myriadrf/LimeSDR-X3/hardware/1v0/Project Outputs for LimeSDR-X3_1v0/DRC/LimeSDR-X3_1v0.html

Altium

# Design Rule Verification Report

Date: | | 2022-12-19
Time: | | 12:21:42
Elapsed Time: | | 00:03:39
Filename: | | E:\Saniok\Lime Micro\Lime PCBs\LimeSDR-X3_1v0\Altium designer design files\PCB\LimeSDR-X3_1v0.PcbDoc

Warnings: | | 0
Rule Violations: | | 0

## Summary

Warnings | Count
Total | 0

Rule Violations | Count
Clearance Constraint (Gap=0.1mm) (All),(All) | 0
Short-Circuit Constraint (Allowed=No) (All),(All) | 0
Short-Circuit Constraint (Allowed=Yes) ((ObjectKind = 'Pad') And (Component = 'IC40') And (Name = 'IC40-PAD') And (AsMM(PadXSize_AllLayers) = 1.4) And (AsMM(PadYSize_AllLayers) = 1.6)),(isvia) | 0
Un-Routed Net Constraint ( (All) ) | 0
Modified Polygon (Allow modified: No), (Allow shelved: No) | 0
Width Constraint (Min=0.1mm) (Max=7mm) (Preferred=0.2mm) (All) | 0
Width Constraint (Min=0.1mm) (Max=5mm) (Preferred=0.2mm) (All) | 0
Routing Layers(All) | 0
Routing Via (MinHoleWidth=0.2mm) (MaxHoleWidth=4.5mm) (PreferredHoleWidth=0.2mm) (MinWidth=0.31mm) (MaxWidth=5mm) (PreferedWidth=0.4mm) (All) | 0
Differential Pairs Uncoupled Length using the Gap Constraints (Min=0.1mm) (Max=0.3mm) (Prefered=0.14mm) and Width Constraints (Min=0.1mm) (Max=0.3mm) (Prefered=0.2mm) (InNetClass('LMS1_RX_RF') or InNetClass('LMS2_RX_RF') or InNetClass('LMS3_RX_RF')) | 0
Differential Pairs Uncoupled Length using the Gap Constraints (Min=0.1mm) (Max=0.3mm) (Prefered=0.1mm) and Width Constraints (Min=0.1mm) (Max=0.5mm) (Prefered=0.2mm) (All) | 0
Differential Pairs Uncoupled Length using the Gap Constraints (Min=0.1mm) (Max=0.3mm) (Prefered=0.14mm) and Width Constraints (Min=0.2mm) (Max=0.2mm) (Prefered=0.2mm) (InNetClass('RAPI_HDMI')) | 0
Differential Pairs Uncoupled Length using the Gap Constraints (Min=0.1mm) (Max=0.3mm) (Prefered=0.14mm) and Width Constraints (Min=0.1mm) (Max=0.3mm) (Prefered=0.2mm) (InNetClass('LMS1_TX_RF') or InNetClass('LMS2_TX_RF') or InNetClass('LMS3_TX_RF')) | 0
Power Plane Connect Rule(Relief Connect )(Expansion=0.508mm) (Conductor Width=0.254mm) (Air Gap=0.254mm) (Entries=4) (All) | 0
Hole Size Constraint (Min=0.2mm) (Max=10mm) (All) | 0
Pads and Vias to follow the Drill pairs settings | 0
Hole To Hole Clearance (Gap=0.15mm) (All),(All) | 0
Minimum Solder Mask Sliver (Gap=0.099mm) (All),(All) | 0
Net Antennae (Tolerance=0mm) (All) | 0
Matched Lengths(Tolerance=1.6mm) (InNetClass('LMS3_BB_ADC2_DATA')) | 0
Matched Lengths(Tolerance=1.6mm) (InNetClass('LMS2_BB_ADC1_DATA')) | 0
Matched Lengths(Tolerance=1.6mm) (InNetClass('LMS2_BB_ADC2_DATA')) | 0
Matched Lengths(Tolerance=1.6mm) (InNetClass('LMS3_BB_ADC1_DATA')) | 0
Matched Lengths(Tolerance=1mm) (InNetClass('LMS2_PORT2')) | 0
Matched Lengths(Tolerance=1mm) (InNetClass('LMS1_PORT1')) | 0
Matched Lengths(Tolerance=1mm) (InNetClass('LMS2_PORT1')) | 0
Matched Lengths(Tolerance=1.6mm) (InNetClass('LMS2_BB_DAC1_DATA')) | 0
Matched Lengths(Tolerance=1mm) (InNetClass('LMS1_PORT2')) | 0
Matched Lengths(Tolerance=1.6mm) (InNetClass('LMS2_BB_DAC2_DATA')) | 0
Matched Lengths(Tolerance=1.6mm) (InNetClass('LMS3_BB')) | 0
Component Clearance Constraint ( Horizontal Gap = -1mm, Vertical Gap = Infinite ) (HasFootprint('SW_4WAY_SMD_1P27_v2')),(All) | 0
Component Clearance Constraint ( Horizontal Gap = -1mm, Vertical Gap = Infinite ) (HasFootprint('RFI_SHIELD_BMI-S-230-F-R')),(All) | 0
Component Clearance Constraint ( Horizontal Gap = -1mm, Vertical Gap = Infinite ) (InComponent('IC40')),(InComponent('IC41')) | 0
Component Clearance Constraint ( Horizontal Gap = -1mm, Vertical Gap = Infinite ) (InComponent('IC36')),(InComponent('IC37')) | 0
Component Clearance Constraint ( Horizontal Gap = -1mm, Vertical Gap = Infinite ) (InComponent('MECH20')),(All) | 0
Component Clearance Constraint ( Horizontal Gap = -1mm, Vertical Gap = Infinite ) (InComponent('R454') or InComponent('R459')),(InComponent('R454') or InComponent('R459')) | 0
Component Clearance Constraint ( Horizontal Gap = -5mm, Vertical Gap = 0.254mm ) (HasFootprint('SFP_Chassis_22273021')),(HasFootprint('SFP_CON_x1_1367073-1')) | 0
Component Clearance Constraint ( Horizontal Gap = 0.01mm, Vertical Gap = 0.254mm ) (All),(All) | 0
Component Clearance Constraint ( Horizontal Gap = -1mm, Vertical Gap = Infinite ) (InComponent('R425') or InComponent('R430') or InComponent('R434')),(InComponent('R425') or InComponent('R430') or InComponent('R434')) | 0
Component Clearance Constraint ( Horizontal Gap = -1mm, Vertical Gap = Infinite ) ((ObjectKind = '3D Body') And (Layer = 'Mechanical13') And (ModelType = 'Extruded') And ((Identifier = 'RFshield') or (Identifier = 'RFshieldTop'))),((ObjectKind = '3D Body') And (Layer = 'Mechanical13') And (ModelType = 'Extruded') And ((Identifier = 'RFshield') or (Identifier = 'RFshieldTop'))) | 0
Height Constraint (Min=0mm) (Max=25.4mm) (Prefered=12.7mm) (All) | 0
Total | 0
