myriadrf/LimeSDR-X3/docs/documentation/images/PCIe_5GRadio_v3.0_3D.png

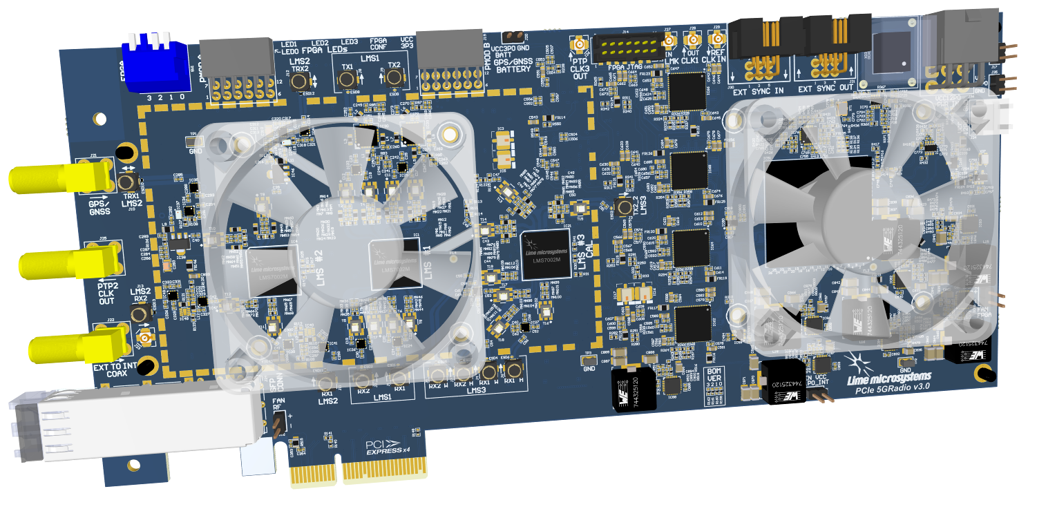
docs/documentation/images/PCIe_5GRadio_v3.0_3D.png
