myriadrf/LimeSDR-X3/hardware/1v1/LimeSDR-X3_1v1_DB_DFMr1/BOM/LimeSDR-X3_1v1_BOMr1.xls

Item # | Comment | Quantity | Designator | Footprint | Manufacturer | Manufacturer Part Number 1 | Supplier 1 | Supplier Part Number 1 | Part Description | Assembly Info | Number of NF parts in row | Number of fitted parts in row | Check
1 | LR44R Battery | 1 | BATT1 |  | Murata | LR44R | DigiKey | 490-LR44R-ND | Coin, 11.6mm Alkaline Manganese Dioxide 1.5 V Battery Non-Rechargeable (Primary) | NF(BATT1) | 1 | 0
2 | LR44R Battery Holder | 1 | BATTH1 | LR44R_BATTERY_HOLDER | Keystone Electronics | 2996 | Digi-Key | 36-2996-ND | Battery Retainer Coin, 11.6mm 1 Cell SMD (SMT) Tab | NF(BATTH1) | 1 | 0
3 | 10pF, 25V | 6 | C1, C3, C5, C783, C790, C793 | CAP0402 | AVX | 04023A100JAT2A | Farnell | 2332478RL | 10pF ±5% 25V C0G, NP0 Ceramic Capacitor -55°C ~ 125°C Surface Mount, MLCC 0402 (1005 Metric) 0.039" L x 0.020" W (1.00mm x 0.50mm) |  |  | 6 | OK
4 | 1uF, 10V | 54 | C2, C4, C6, C259, C260, C261, C275, C282, C283, C284, C298, C317, C322, C344, C349, C500, C512, C524, C525, C535, C538, C542, C545, C553, C556, C559, C562, C567, C574, C701, C702, C716, C720, C722, C727, C730, C748, C758, C771, C772, C784, C788, C808, C819, C820, C834, C859, C860, C861, C886, C887, C888, C905, C939 | CAP0402 | TDK | C1005X5R1E105K050BC | Digi-Key | 445-9066-1-ND | 1µF ±10% 10V X5R Ceramic Capacitor -55°C ~ 85°C Surface Mount, MLCC 0402 (1005 Metric) 0.039" L x 0.020" W (1.00mm x 0.50mm) | NF(C748 C758 C771 C772) | 4 | 50 | OK
5 | 100nF, 16V | 313 | C7, C9, C11, C14, C17, C20, C21, C24, C25, C26, C43, C46, C47, C50, C55, C57, C60, C62, C65, C68, C69, C263, C276, C280, C286, C299, C303, C307, C312, C318, C333, C337, C345, C359, C360, C361, C362, C363, C364, C365, C366, C367, C368, C369, C370, C371, C379, C380, C383, C384, C385, C386, C387, C388, C391, C392, C393, C394, C395, C396, C399, C400, C401, C402, C403, C404, C407, C408, C409, C410, C411, C412, C415, C416, C417, C418, C419, C420, C423, C424, C425, C426, C427, C428, C431, C432, C433, C434, C435, C436, C439, C440, C441, C442, C443, C444, C449, C450, C451, C452, C453, C454, C455, C456, C457, C458, C459, C460, C461, C464, C465, C466, C467, C468, C472, C473, C474, C475, C477, C478, C479, C480, C481, C482, C483, C484, C485, C486, C488, C489, C490, C491, C492, C493, C494, C495, C496, C497, C498, C499, C501, C502, C503, C508, C509, C510, C515, C516, C517, C518, C526, C527, C528, C529, C536, C539, C540, C543, C546, C547, C554, C557, C560, C563, C568, C569, C570, C571, C572, C575, C576, C577, C578, C579, C580, C581, C582, C583, C588, C589, C590, C595, C596, C598, C599, C603, C604, C605, C606, C610, C611, C612, C613, C618, C619, C620, C625, C626, C628, C629, C633, C634, C635, C636, C640, C641, C642, C644, C648, C649, C650, C655, C656, C658, C659, C663, C664, C665, C666, C670, C671, C672, C673, C678, C679, C680, C685, C686, C688, C689, C693, C694, C695, C696, C700, C703, C705, C711, C712, C713, C714, C715, C717, C719, C723, C724, C725, C726, C728, C731, 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
15 | 1nF, 50V | 13 | C265, C266, C274, C281, C288, C289, C297, C304, C721, C736, C777, C778, C787 | CAP0402 | Murata Electronics | GCM155R71H102KA37D | Mouser | 81-GCM155R71H102KA7D | 1000pF ±10% 50V X7R Ceramic Capacitor -55°C ~ 125°C Surface Mount, MLCC 0402 (1005 Metric) 0.039" L x 0.020" W (1.00mm x 0.50mm) |  |  | 13 | OK
16 | 2700pF, 50V | 4 | C267, C290, C319, C346 | CAP0402 | Murata Electronics North America | GRM155R71H272KA01J | Digi-Key | 490-6361-1-ND | 2700pF ±10% 50V Ceramic Capacitor X7R 0402 (1005 Metric) | NF(C267 C290 C319 C346) | 4 | 0 | OK
17 | 2.2pF, 50V | 2 | C277, C300 | CAP0402 | Samsung Electro-Mechanics America, Inc. | CL05C2R2CB5NNNC | Digi-Key | 1276-1271-1-ND | 2.2pF ±0.25pF 50V Ceramic Capacitor C0G, NP0 0402 (1005 Metric) |  |  | 2 | OK
18 | 1200pF, 50V | 6 | C306, C334, C890, C892, C894, C908 | CAP0402 | Kemet | C0402C122J5GACTU | Digi-Key | 399-7334-1-ND | 1200pF ±5% 50V Ceramic Capacitor C0G, NP0 0402 (1005 Metric) |  |  | 6 | OK
19 | 0.018uF, 25V | 2 | C309, C336 | CAP0402 | Yageo | CC0402KRX7R8BB183 | Digi-Key | 311-3345-1-ND | 0.018µF ±10% 25V Ceramic Capacitor X7R 0402 (1005 Metric) | NF(C309 C336) | 2 | 0 | OK
20 | 22nF, 50V | 19 | C372, C373, C374, C375, C376, C504, C505, C506, C507, C802, C868, C869, C870, C896, C897, C898, C909, C910, C911 | CAP0402 | Kemet | C0402C223K5RACTU | Digi-Key | 399-7780-1-ND | 0.022µF ±10% 50V Ceramic Capacitor X7R 0402 (1005 Metric) |  |  | 19 | OK
21 | 47uF, 6.3V | 20 | C377, C381, C389, C397, C405, C413, C421, C429, C437, C447, C462, C469, C470, C851, C854, C857, C883, C884, C901, C902 | CAP1206 | Samsung Electro-Mechanics | CL31A476MQHNNNE | Digi-Key | 1276-1167-1-ND | 47µF ±20% 6.3V Ceramic Capacitor X5R 1206 (3216 Metric) | NF(C902) | 1 | 19 | OK
22 | 4.7uF, 6.3V | 33 | C378, C382, C390, C398, C406, C414, C422, C430, C438, C448, C463, C471, C476, C487, C895, C927, C928, C929, C930, C931, C932, C933, C934, C935, C936, C937, C938, C941, C942, C943, C944, C945, C946 | CAP0402 | Murata Electronics North America | GRM155R60J475ME87D | Digi-Key | 490-5408-1-ND | 4.7µF ±20% 6.3V X5R Ceramic Capacitor -55°C ~ 85°C Surface Mount, MLCC 0402 (1005 Metric) 0.039" L x 0.020" W (1.00mm x 0.50mm) |  |  | 33 | OK
23 | 220uF, 4V | 9 | C445, C446, C850, C852, C853, C855, C856, C858, C882 | CAP1206 | Murata Electronics North America | GRM31CR60G227ME11L | Digi-Key | 490-9774-1-ND | 220µF ±20% 4V Ceramic Capacitor X5R 1206 (3216 Metric) | NF(C852 C855 C858 C882) | 4 | 5 | OK
24 | 22pF, 50V | 12 | C511, C585, C592, C615, C622, C645, C652, C675, C682, C779, C780, C781 | CAP0402 | Yageo | CC0402JRNPO9BN220 | Digi-Key | 311-1018-2-ND | 22pF ±5% 50V C0G, NP0 Ceramic Capacitor -55°C ~ 125°C Surface Mount, MLCC 0402 (1005 Metric) 0.039" L x 0.020" W (1.00mm x 0.50mm) |  |  | 12 | OK
25 | 22uF, 10V | 44 | C530, C531, C532, C533, C548, C549, C550, C551, C564, C565, C597, C600, C601, C607, C608, C627, C630, C631, C637, C638, C657, C660, C661, C667, C668, C687, C690, C691, C697, C698, C704, C706, C707, C708, C709, C710, C733, C734, C915, C916, C919, C920, C922, C923 | CAP0603 | TDK Corporation | C1608X5R1A226M080AC | Mouser | 810-C1608X5R1A226M | 22µF ±20% 10V X5R Ceramic Capacitor -55°C ~ 85°C Surface Mount, MLCC 0603 (1608 Metric) 0.063" L x 0.031" W (1.60mm x 0.80mm) |  |  | 44 | OK
26 | 4.7pF, 50V | 18 | C584, C586, C591, C593, C614, C616, C621, C623, C643, C646, C651, C653, C674, C676, C681, C683, C891, C893 | CAP0402 | MURATA | GRM1555C1H4R7CA01D | Farnell | 2434644 | 4.7pF ±0.25pF 50V Ceramic Capacitor C0G, NP0 0402 (1005 Metric) |  |  | 18 | OK
27 | 2.2uF, 16V | 5 | C749, C754, C809, C812, C839 | CAP0402 | TDK Corporation | C1005X5R1C225K050BC | Digi-Key | 445-9085-6-ND | 2.2µF ±10% 16V Ceramic Capacitor X5R 0402 (1005 Metric) |  |  | 5 | OK
28 | 18nF, 16V | 1 | C760 | CAP0402 | Yageo | CC0402KRX7R7BB183 | Digi-Key | 311-1706-1-ND | 0.018µF ±10% 16V Ceramic Capacitor X7R 0402 (1005 Metric) | NF(C760) | 1 | 0 | OK
29 | 220pF, 10% | 1 | C782 | CAP0402 | Yageo | CC0402KRX7R9BB221 | Digi-Key | 311-1035-2-ND | 220pF ±10% 50V X7R Ceramic Capacitor -55°C ~ 125°C Surface Mount, MLCC 0402 (1005 Metric) 0.039" L x 0.020" W (1.00mm x 0.50mm) |  |  | 1 | OK
30 | 47pF, 50V | 6 | C798, C799, C800, C801, C804, C805 | CAP0402 | TDK Corporation | C1005C0G1H470F050BA | Digi-Key | 445-5361-1-ND | 47pF ±1% 50V Ceramic Capacitor C0G, NP0 0402 (1005 Metric) | NF(C798 C799 C800 C801 C804 C805) | 6 | 0 | OK
31 | 10uF, 25V | 7 | C847, C848, C849, C874, C875, C876, C900 | CAP0805 | Yageo | CC0805KKX5R8BB106 | Digi-Key | 311-1869-1-ND | 10 µF ±10% 25V Ceramic Capacitor X5R 0805 (2012 Metric) |  |  | 7 | OK
32 | 1500pF, 50V | 3 | C863, C865, C867 | CAP0402 | Samsung Electro-Mechanics America, Inc. | CL05B152KB5NNNC | Digi-Key | 1276-1521-1-ND | 1500pF ±10% 50V Ceramic Capacitor X7R 0402 (1005 Metric) |  |  | 3 | OK
33 | 100uF, 6.3V | 7 | C877, C878, C879, C880, C881, C885, C903 | CAP1206 | MURATA | GRM31CR60J107ME39L. | Farnell | 1735535 | SMD Multilayer Ceramic Capacitor, 1206 [3216 Metric], 100 µF, 6.3 V, ± 20%, X5R, GRM Series | NF(C885 C903) | 2 | 5 | OK
34 | 8.2pF, 50V | 1 | C889 | CAP0402 | Samsung | CL05C8R2DB5NNNC | Digi-Key | 1276-1730-1-ND | 8.2pF ±0.5pF 50V Ceramic Capacitor C0G, NP0 0402 (1005 Metric) |  |  | 1 | OK
35 | 2.2pF | 1 | C907 | CAP0402 | Samsung Electro-Mechanics America, Inc. | CL05C2R2CB5NNNC | Digi-Key | 1276-1271-1-ND | 2.2pF ±0.25pF 50V Ceramic Capacitor C0G, NP0 0402 (1005 Metric) |  |  | 1 | OK
36 | 16pF, 50V | 3 | C924, C925, C926 | CAP0402 | Yageo | CC0402JRNPO9BN160 | Digi-Key | 311-1662-1-ND | 16 pF ±5% 50V Ceramic Capacitor C0G, NP0 0402 (1005 Metric) |  |  | 3 | OK
37 | ESD8472 | 14 | ESD1, ESD2, ESD3, ESD4, ESD5, ESD6, ESD7, ESD8, ESD9, ESD10, ESD11, ESD12, ESD13, ESD14 | ESD8472_X3DFN2 | ON Semiconductor | ESD8472MUT5G | Digi-Key | ESD8472MUT5GOSCT-ND | TVS DIODE 5.3VWM 14VC X3DFN2 | NF(ESD1 ESD2 ESD3 ESD4 ESD5 ESD6 ESD7 ESD8 ESD9 ESD10 ESD11 ESD12 ESD13 ESD14) | 14 | 0
38 | Fiducial | 8 | F1, F2, F3, F4, F5, F6, F7, F8 | Fiducial |  |  |  |  |  |  |  | 8
39 | DC FAN 60mm (Top) | 2 | FAN1, FAN2 | FAN_60mm | Sunon | HA60151V4-1000U-A99 | Digi-Key | 259-1792-ND | Fan Tubeaxial 12VDC Square - 60mm L x 60mm H Vapo-Bearing™ 12.7 CFM (0.356m³/min) 2 Wire Leads |  |  | 2
40 | Fiducial | 8 | FD1, FD2, FD3, FD4, FL17, FL18, FL19, FL20 | Fiducial_local |  |  |  |  |  |  |  | 8
41 | LFCV-52+ | 16 | FL1, FL2, FL3, FL4, FL5, FL6, FL7, FL8, FL9, FL10, FL11, FL12, FL13, FL14, FL15, FL16 | LFCV-52+_LPF_v2 | Mini Circuits | LFCV-52+ | Mini Circuits | LFCV-52+ | Ceramic Low Pass Filter, 50Ω, DC to 52 MHz |  |  | 16
42 | 600R, 0.27A | 99 | FR1, FR2, FR3, FR4, FR5, FR6, FR7, FR8, FR9, FR10, FR11, FR12, FR13, FR14, FR15, FR16, FR17, FR18, FR19, FR20, FR21, FR22, FR23, FR24, FR25, FR26, FR27, FR28, FR29, FR30, FR31, FR32, FR33, FR34, FR35, FR36, FR37, FR38, FR39, FR40, FR41, FR42, FR43, FR44, FR45, FR46, FR47, FR48, FR49, FR50, FR51, FR52, FR53, FR54, FR55, FR56, FR57, FR58, FR59, FR60, FR61, FR62, FR63, FR64, FR65, FR66, FR67, FR68, FR69, FR70, FR71, FR72, FR73, FR74, FR75, FR76, FR77, FR78, FR79, FR80, FR81, FR82, FR83, FR84, FR85, FR86, FR87, FR88, FR89, FR90, FR91, FR92, FR93, FR94, FR95, FR96, FR97, FR98, FR99 | RES0201 | Taiyo Yuden | BK0603TS601-T | Digi-Key | 587-3277-1-ND | FERRITE BEAD 600 OHM 0201 1LN |  |  | 99 | OK
43 | 600R, 2A | 55 | FR100, FR101, FR102, FR103, FR105, FR106, FR107, FR108, FR109, FR110, FR111, FR112, FR113, FR114, FR115, FR116, FR117, FR118, FR119, FR120, FR121, FR122, FR123, FR124, FR125, FR126, FR127, FR128, FR129, FR130, FR131, FR132, FR139, FR140, FR142, FR143, FR144, FR145, FR146, FR147, FR148, FR149, FR150, FR151, FR152, FR153, FR154, FR155, FR156, FR157, FR158, FR159, FR160, FR161, FR162 | RES0805 | TDK Corporation | MPZ2012S601AT000 | Digi-Key | 445-2206-2-ND | FERRITE BEAD 600 OHM 0805 1LN | NF(FR156 FR157 FR161) | 3 | 52 | OK
44 | Ferrite | 7 | FR104, FR133, FR134, FR135, FR137, FR138, FR163 | RES0402 | Murata | BLM15AX601SN1D | Digi-Key | 490-5441-1-ND | - Ferrite Bead 0402 (1005 Metric) 500mA 340mOhm | NF(FR163) | 1 | 6 | OK
45 | Ferrite | 2 | FR136, FR141 | RES0201 | Taiyo Yuden | BK0603TS601-T | Digi-Key | 587-3277-1-ND | FERRITE BEAD 600 OHM 0201 1LN |  |  | 2 | OK
46 | 0R | 5 | FUSE1, FUSE2, R528, R546, R549 | RES0805 | Vishay Dale | CRCW08050000Z0EA | Digi-Key | 541-0.0ATR-ND | RES SMD 0.0 OHM JUMPER 1/8W 0805 | NF(FUSE1 R528 R546) | 3 | 2 | OK
47 | LMS7002M | 3 | IC1, IC3, IC5 | LMS7002M_v5 | Lime Microsystems | LMS7002M | Lime Microsystems | LMS7002M | IC FPRF Transceiver LMS7002M; 261 pin aQFN |  |  | 3
48 | CAT24C128WI-GT3 | 4 | IC2, IC4, IC6, IC43 | SOIC127P600-8DL_v2 | ON Semiconductor | CAT24C128WI-GT3 | Digi-Key | CAT24C128WI-GT3CT-ND | EEPROM Memory IC 128Kb (16K x 8) I²C 1MHz 400ns 8-SOIC |  |  | 4
49 | PE42422 | 14 | IC7, IC8, IC9, IC10, IC11, IC12, IC23, IC24, IC28, IC30, IC31, IC32, IC36, IC38 | PE42422_QFN12 | Peregrine Semiconductor | PE42422MLAA-Z | Digi-Key | 1046-1062-1-ND | IC RF SWITCH SPDT 50 OHM 12QFN |  |  | 14
50 | PS22917 | 4 | IC13, IC18, IC27, IC35 | SOT23-6 | Texas Instruments | TPS22917DBVR | Digi-Key | 296-50498-1-ND | Power Switch/Driver 1:1 P-Channel 2A SOT-23-6 |  |  | 4
51 | QPA4563A | 4 | IC14, IC16, IC19, IC21 | QPA4563ATR7_SOT363-6 | Qorvo | QPA4563ATR7 | Mouser | 772-QPA4563ATR7 | RF Amplifier DC-3.5GHZ NF 2.5dB Gain 20.4dB |  |  | 4
52 | F2258NLGK8 | 2 | IC15, IC20 | F2258NLGK8 _QFN3x3_16 | IDT | F2258NLGK8 | Mouser | 972-F2258NLGK8 | Attenuators RF Attenuator 1.4dB 50 to 6000 MHz |  |  | 2
53 | AD5662 | 5 | IC17, IC22, IC58, IC61, IC65 | AD5662_SOT23-8 | Analog Devices Inc. | AD5662BRJZ-2REEL7 | Digi-Key | AD5662BRJZ-2REEL7CT-ND | IC DAC 16BIT BUFF V-OUT SOT23-8 |  |  | 5
54 | TQP369182 | 2 | IC25, IC33 | PGA-102+_SOT89 | Qorvo | TQP369182 | Mouser | 772-TQP369182 | RF Amplifier DC-6GHz NF 3.9dB Gain 21.3dB 50 Ohm |  |  | 2
55 | DC2337J5020AHF | 2 | IC26, IC34 | DC2337J5020AHF_ANAREN_COUPLER_0805 | Anaren | DC2337J5020AHF | Digi-Key | 1173-1090-2-ND | RF Directional Coupler General Purpose 2.3GHz ~ 3.7GHz 21.3dB 2W 0805 (2012 Metric) |  |  | 2
56 | TQL9092 | 2 | IC29, IC37 | TQL9092 | Qorvo | TQL9092 | Mouser | 772-TQL9092 | RF Amplifier .6-4.2GHz NF .6dB Flat Gain 2dB |  |  | 2
57 | XC7A200T-2FBG676C | 1 | IC39 | XC7A200T-2FBG676C_FBG676 | Xilinx | XC7A200T-2FBG676C | Digi-Key | 122-1865-ND | IC FPGA 400 I/O 676FCBGA |  |  | 1
58 | MT25QL128 | 1 | IC40 | S25FL164K_WSON8_DFN6 | Micron Technology | MT25QL128ABA1ESE-0SITTR | Digi-Key | 557-1772-1-ND | FLASH - NOR Memory IC 128Mb (16M x 8) SPI 133MHz 8-SO | NF(IC40) | 1 | 0
59 | MX25L25635FMI | 1 | IC41 | SOIC16_WIDE | Macronix | MX25L25635FMI-10G | Digi-Key | 1092-1149-ND | FLASH - NOR Memory IC 256Mb (32M x 8) SPI 104MHz 16-SOP |  |  | 1
60 | LM75 | 1 | IC42 | HWSON8_LM75 | NXP Semiconductors | LM75BTP,147 | Digi-Key | 568-9815-2-ND | SENSOR TEMPERATURE I2C 8HWSON |  |  | 1
61 | ATECC508A | 1 | IC44 | ATECC508A_UDFN8 | Microchip | ATECC508A-MAHDA-S | Digi-Key | ATECC508A-MAHDA-SDKR-ND | Authentication Chip IC Networking and Communications 8-UDFN (2x3) |  |  | 1
62 | ATECC508A | 1 | IC45 | SOIC127P600-8DL_v2 | Microchip Technology | ATECC508A-SSHDA-T | Digi-Key | ATECC508A-SSHDA-TCT-ND | Authentication Chip IC Networking and Communications 8-SOIC | NF(IC45) | 1 | 0
63 | LYNQ N20B | 1 | IC46 | NEO-7M/8M | RF channe; | LYNQ N20B | Lime Microsystems | LYNQ N20B | GNSS engine for GPS/QZSS, GLONASS receiver |  |  | 1
64 | SN74AVC1T45DBV | 2 | IC47, IC68 | SOT23-6 | Texas Instruments | SN74AVC1T45DBVR | Digi-Key | 296-19094-1-ND | Voltage Level Translator Bidirectional 1 Circuit 1 Channel 500Mbps SOT-23-6 |  |  | 2
65 | MAX5878 | 2 | IC48, IC49 | MAX5878_QFN68 | Maxim | MAX5878EGK+D | Digi-Key | MAX5878EGK+D-ND | 16 Bit Digital to Analog Converter 2 68-QFN-EP (10x10) |  |  | 2
66 | ADS4246IRGCR | 4 | IC50, IC52, IC54, IC56 | TI-RGC64-7400X7400TP_V | Texas Instruments | ADS4246IRGCT | Digi-Key | 296-28772-1-ND | 14 Bit Analog to Digital Converter 2 Input 2 Pipelined 64-VQFN (9x9) |  |  | 4
67 | ADA4930-2 | 4 | IC51, IC53, IC55, IC57 | ADA4930-2_LFCSP-24 | Analog Devices Inc. | ADA4930-2YCPZ-R7 | Digi-Key | ADA4930-2YCPZ-R7CT-ND | Differential Amplifier 2 Circuit Differential 24-LFCSP-WQ (4x4) |  |  | 4
68 | CDCM61004RHB | 1 | IC59 | CDCM61004RHB_CLK_GEN_VQFN32 | Texas Instruments | CDCM61004RHBT | Digi-Key | 296-24194-1-ND | Clock Generator IC 683.27MHz 32-VFQFN Exposed Pad |  |  | 1
69 | LP5951 | 1 | IC60 | LP5951MF_SOT23-5 | TI National Semiconductor | LP5951MF-3.0/NOPB | Digi-Key | LP5951MF-3.0/NOPBCT-ND | Linear Voltage Regulator IC Output 150mA SOT-23-5 | NF(IC60) | 1 | 0
70 | LMK00101 | 2 | IC62, IC66 | LMK00101_WQFN32 | Texas Instruments | LMK00101SQE/NOPB | Digi-Key | 296-39036-1-ND | Clock Fanout Buffer (Distribution), Multiplexer, Translator IC 200MHz 32-WFQFN Exposed Pad |  |  | 2
71 | LP5907-3.0 | 1 | IC63 | SOT23-5 | Texas Instruments | LP5907QMFX-3.0Q1 | Digi-Key | 296-40364-1-ND | Linear Voltage Regulator IC Positive Fixed 1 Output 250mA SOT-23-5 | NF(IC63) | 1 | 0
72 | ADF4002 | 1 | IC64 | ADF4002 | Analog Devices Inc | ADF4002BCPZ-RL7 | Digi-Key | ADF4002BCPZ-RL7CT-ND | IC PLL FREQUENCY SYNTH 20-LFCSP |  |  | 1
73 | CDCM6208V2GRGZR | 1 | IC67 | CDCM6208V2G _VQFN48 | Texas Instruments | CDCM6208V2GRGZR | Digi-Key | 296-51011-1-ND | IC CLK GEN 2:8 LOW JITTER 48VQFN |  |  | 1
74 | SN65LVDS1 | 1 | IC69 | SOT23-5 | TEXAS INSTRUMENTS | SN65LVDS1DBVR | Newark | 76C0715 | DIFFERENTIAL LINE DRIVER/RECEIVER SIGNAL SOT23-5 |  |  | 1
75 | ADP2386 | 7 | IC70, IC71, IC72, IC73, IC74, IC75, IC76 | ADP2386 | Analog Devices Inc. | ADP2386ACPZN-R7 | Digi-Key | ADP2386ACPZN-R7DKR-ND | Buck Switching Regulator IC Positive Adjustable 0.6V 1 Output 6A 24-WFQFN Exposed Pad, CSP |  |  | 7
76 | LMZ20501SILR | 3 | IC77, IC78, IC79 | LMZ20501SILR_DC-DC_8-SMD | Texas Instruments | LMZ20501SILR | Digi-Key | 296-40328-1-ND | Non-Isolated PoL Module DC DC Converter 1 Output 0.8 ~ 3.6V 1A 2.7V - 5.5V Input |  |  | 3
77 | AP7361-FGE | 9 | IC80, IC81, IC82, IC83, IC84, IC85, IC86, IC87, IC88 | AP7361 | Diodes Incorporated | AP7361-FGE-7 | Digi-Key | AP7361-FGE-7DICT-ND | IC REG LDO ADJ 1A 8DFN |  |  | 9
78 | AS431 | 1 | IC89 | SOT23-3_v2 | Diodes | AS431ANTR-G1 | Digi-Key | AS431ANTR-G1DICT-ND | Shunt Voltage Reference IC Adjustable 2.5V 36 VV ±0.5% 100 mA SOT-23-3 |  |  | 1
79 | U.FL/MMCX | 13 | J1, J2, J3, J4, J5, J6, J7, J8, J9, J10, J11, J12, J13 | MMCX_UFL_conn_m | Amphenol RF | 908-22101T | Digi-Key | ARF1725CT-ND | MMCX Connector Jack, Female Socket 50Ohm Surface Mount Solder |  |  | 13
80 | 878321420 | 1 | J14 | MOLEX-878321420_V | Molex | 87832-1420 | Digi-Key | WM18641-ND | Connector Header Surface Mount 14 position 0.079" (2.00mm) |  |  | 1
81 | PMOD connector | 2 | J15, J19 | PMODconn_right_angle_TH | Sullins Connector Solutions | PPPC062LJBN-RC | Digi-Key | S5559-ND | 12 Position Header Connector 0.100" (2.54mm) Through Hole, Right Angle Gold |  |  | 2
82 | Header | 5 | J16, J17, J18, J32, J35 | HDR_1x2 | Wurth Electronics | 61300211121 | Digi-Key | 732-5315-ND | Connector Header Through Hole 2 position 0.100" (2.54mm) | NF(J32) | 1 | 4
83 | Batt | 1 | J20 | HDR_1x2 | 3M | 961102-6404-AR | Digi-Key | 3M9447-ND | 2 Positions Header, Unshrouded Connector 0.100" (2.54mm) Through Hole Gold | NF(J20) | 1 | 0
84 | SMA panel mount | 3 | J21, J22, J25 | SMA_connector_side | Linx | CONSMA002-L-G | Digi-Key | CONSMA002-L-G-ND | SMA Connector Receptacle, Female Socket 50Ohm Panel Mount, Through Hole, Right Angle Solder |  |  | 3
85 | U.FL/MMCX | 5 | J23, J26, J27, J28, J29 | MMCX_UFL_conn_u | Molex, LLC | 0734120110 | Digi-Key | WM5587CT-ND | CONN UMC RCPT STR 50 OHM SMD |  |  | 5
86 | 1367073-1 | 1 | J24 | SFP_CON_x1_1367073-1 | TE Connectivity | 1367073-1 | Digi-Key | A97430CT-ND | 20 Position SFP Receptacle Connector Solder Surface Mount, Right Angle |  |  | 1
87 | Header 3X2 | 2 | J30, J31 | BHR-06-HUA_2x3_EDGE_HEADER | Adam Equipment | BHR-06-HUA | Digi-Key | 2057-BHR-06-HUA-ND | Connector Header Through Hole, Right Angle 6 position 0.100" (2.54mm) |  |  | 2
88 | 3-640441-2 | 1 | J33 |  | AMP - TE CONNECTIVITY | 3-640441-2 | Digi-Key | A30978-ND | 2 Position Rectangular Receptacle Connector IDC Tin 24 AWG |  |  | 1
89 | 12V | 1 | J34 | 1744037-2_CONNECTOR_1X2 | TE Connectivity AMP Connectors | 1744037-2 | Digi-Key | A112698-ND | Connector Header Through Hole 2 position 0.200" (5.08mm) |  |  | 1
90 | 6-pin PCIe power | 1 | J36 | PCIe_POWER_HEADER_6PIN | Molex Connector Corporation | 0455580003 | Digi-Key | WM10869-ND | 6 Positions Header, Shrouded Connector 0.165" (4.20mm) Through Hole, Right Angle Tin |  |  | 1
91 | 22nH, 350mA | 4 | L1, L2, L3, L4 | RES0603 | Murata | LQW18AN22NG00D | Digi-Key | 490-6874-1-ND | 22 nH Unshielded Wirewound Inductor 500 mA 170mOhm Max 0603 (1608 Metric) |  |  | 4 | OK
92 | 15nH, 600mA | 2 | L5, L7 | RES0805 | Bourns | CW201212-15NJ | Digi-Key | CW201212-15NJDKR-ND | 15nH Unshielded Wirewound Inductor 600mA 80mOhm 0805 (2012 Metric) |  |  | 2 | OK
93 | 18nH, 10% | 2 | L6, L8 | RES0603 | Pulse Electronics Network | PE-0603CD180KTT | Digi-Key | 1840-1105-1-ND | 18nH Unshielded Wirewound Inductor 700mA 170 mOhm Max 0603 (1608 Metric) |  |  | 2 | OK
94 | 47nH | 7 | L9, MN21, MN22, MN23, MN24, MN91, MN92 | RES0402 | COILCRAFT | 0402HP-47NXJLU | Farnell | 2285856 | INDUCTOR, RF, 47NH, 5%, 2.4GHZ, SMD; Product Range:0402HP Series; Inductance:47nH; Inductance Tolerance:± 5%; High Frequency Inductor Case:0402 [1005 Metric]; Self Resonant Frequency Min:2.4GHz; DC Resistance Max:0.58ohm; DC Current Rating:420mA |  |  | 7 | OK
95 | 1µH | 3 | L10, L11, L12 | FDVE1040_TOKO_INDUCTOR | Vishay Dale | IHLP3232DZER1R0M01 | Digi-Key | 541-1371-6-ND | 1µH Shielded Molded Inductor 18A 5.78 mOhm Max Nonstandard |  |  | 3
96 | 1.5uH | 1 | L13 | FDVE1040_TOKO_INDUCTOR | Vishay Dale | IHLP4040DZER1R5M01 | Digi-Key | 541-1301-6-ND | FIXED IND 1.5UH 15A 5.8 MOHM SMD |  |  | 1
97 | 2.2µH | 2 | L14, L15 | FDVE1040_TOKO_INDUCTOR | Vishay Dale | IHLP4040DZER2R2M01 | Digi-Key | 541-1299-1-ND | 2.2µH Shielded Molded Inductor 12A 9 mOhm Max Nonstandard |  |  | 2
98 | 3.3µH | 1 | L16 | FDVE1040_TOKO_INDUCTOR | Vishay Dale | IHLP4040DZER3R3M01 | Digi-Key | 541-1298-1-ND | 3.3µH Shielded Molded Inductor 10A 14.4 mOhm Max Nonstandard |  |  | 1
99 | LED RG Angle | 6 | LED1, LED2, LED3, LED4, LED5, LED6 | LED_RG_RIGHT_ANGLE_v3 | Stanley Electric | BRPY1211FTR | Arrow Electronics | BRPY1211F-TR | Green, Red 572nm Green, 647nm Red LED Indication - Discrete 2.1V Green, 1.7V Red 2-SMD, No Lead |  |  | 6
100 | PCIe bracket | 1 | MECH1 | PCIe_bracket | Keystone Electronics | 9200 | Digi-Key | 36-9200-ND | BRACKET COMPUTER EISA/ISA OR PCI |  |  | 1
101 | Spacer M3 | 7 | MECH2, MECH3, MECH4, MECH5, MECH20, MECH21, MECH22 |  | BOSSARD | TDYSFF-M3/10 | TME | TDYSFF-M3/10 | Screwed spacer sleeve; Int.thread: M3; 25mm; brass |  |  | 7
102 | Screws M3 | 14 | MECH6, MECH7, MECH8, MECH9, MECH10, MECH11, MECH12, MECH13, MECH23, MECH24, MECH25, MECH26, MECH27, MECH28 |  | BOSSARD | 1003755 | TME | 1003755 | Screw; M3x6; DIN:912; Head: cheese head; imbus; steel; zinc |  |  | 14
103 | 2x1 pos. 0.1' header receptacle | 1 | MECH14 |  | Molex | 0014562021 | Digi-Key | 23-0014562021-ND | 2 Position Rectangular Receptacle Connector IDC Gold 24 AWG |  |  | 1
104 | Standoff | 4 | MECH15, MECH16, MECH17, MECH18 | PCB_standoff | FIX&FASTEN | FIX-MAE-5TV | TME | FIX-MAE-5TV | PCB distance; polyamide; L:5mm; Colour: natural; Øcutout:3mm | NF(MECH15 MECH16 MECH17 MECH18) | 4 | 0
105 | 2227302-1 | 1 | MECH19 | SFP_Chassis_22273021 | TE Connectivity AMP | 2227302-1 | Digi-Key | A120616-ND | - Position SFP Cage Connector Press-Fit Through Hole, Right Angle |  |  | 1
106 | 0uH (0R) | 12 | MN1, MN2, MN3, MN4, MN49, MN50, MN51, MN52, MN73, MN74, MN75, MN76 | RES0603 | Panasonic Electronic Components | ERJ-3GEY0R00V | Digi-Key | P0.0GCT-ND | 0 Ohms Jumper 0.1W, 1/10W Chip Resistor 0603 (1608 Metric) Automotive AEC-Q200 Thick Film |  |  | 12 | OK
107 | 8.2nH, 5% | 6 | MN5, MN6, MN7, MN8, MN35, MN37 | RES0402 | COILCRAFT | 0402HP-8N2XJLU | Farnell | 2285826 | INDUCTOR, RF, 8.2NH, 5%, 5.4GHZ, SMD; Product Range:0402HP Series; Inductance:8.2nH; Inductance Tolerance:± 5%; High Frequency Inductor Case:0402 [1005 Metric]; Self Resonant Frequency Min:5.4GHz; DC Resistance Max:0.065ohm; DC Current Rating:1.5A | NF(MN35 MN37) | 2 | 4 | OK
108 | 0.8pF | 6 | MN9, MN10, MN15, MN16, MN108, MN110 | CAP0402 | Murata Electronics North America | GRM1555C1HR80BA01D | Digi-Key | 490-6269-1-ND | 0.80pF ±0.1pF 50V C0G, NP0 Ceramic Capacitor -55°C ~ 125°C Surface Mount, MLCC 0402 (1005 Metric) 0.039" L x 0.020" W (1.00mm x 0.50mm) |  |  | 6 | OK
109 | 1pF | 4 | MN11, MN13, MN45, MN46 | CAP0402 | TDK Corporation | C1005C0G1H010B050BA | Digi-Key | 445-4854-6-ND | 1pF ±0.1pF 50V C0G, NP0 Ceramic Capacitor -55°C ~ 125°C Surface Mount, MLCC 0402 (1005 Metric) 0.039" L x 0.020" W (1.00mm x 0.50mm) | NF(MN11 MN13) | 2 | 2 | OK
110 | 0.5pF | 11 | MN12, MN14, MN27, MN29, MN43, MN44, MN60, MN62, MN84, MN85, MN94 | CAP0402 | Yageo | CC0402CRNPO9BNR50 | Digi-Key | 311-1001-1-ND | 0.50pF ±0.25pF 50V C0G, NP0 Ceramic Capacitor -55°C ~ 125°C Surface Mount, MLCC 0402 (1005 Metric) 0.039" L x 0.020" W (1.00mm x 0.50mm) | NF(MN27 MN29 MN43 MN44 MN94) | 5 | 6 | OK
111 | 100uH | 6 | MN17, MN18, MN19, MN20, MN89, MN90 | RES0603 | TDK Corporation | GLFR1608T101M-LR | Digi-Key | 445-6150-6-ND | 100µH Shielded Wirewound Inductor 80mA 5.5 Ohm 0603 (1608 Metric) |  |  | 6 | OK
112 | 2pF | 7 | MN28, MN30, MN41, MN42, MN47, MN48, MN95 | CAP0402 | AVX | 04025U2R0BAT2A | Farnell | 2332536 | 2pF ±0.1pF 50V C0G, NP0 Ceramic Capacitor -55°C ~ 125°C Surface Mount, MLCC 0402 (1005 Metric) 0.039" L x 0.020" W (1.00mm x 0.50mm) |  |  | 7 | OK
113 | 510pF | 4 | MN33, MN34, MN39, MN40 | CAP0402 | Murata Electronics North America | GRM1555C1H511JA01D | Digi-Key | 490-3237-1-ND | 510pF ±5% 50V C0G, NP0 Ceramic Capacitor -55°C ~ 125°C Surface Mount, MLCC 0402 (1005 Metric) 0.039" L x 0.020" W (1.00mm x 0.50mm) |  |  | 4 | OK
114 | 1.2pF | 2 | MN36, MN38 | CAP0402 | Murata Electronics North America | GRM1555C1H1R2CA01D | Digi-Key | 490-5927-1-ND | '1.2pF ±0.25pF 50V C0G, NP0 Ceramic Capacitor -55°C ~ 125°C Surface Mount, MLCC 0402 (1005 Metric) 0.039" L x 0.020" W (1.00mm x 0.50mm) |  |  | 2 | OK
115 | 4.7nH, ±0.2 | 8 | MN53, MN54, MN55, MN56, MN77, MN78, MN79, MN80 | RES0402 | Murata | LQW15AN4N7C00D | Digi-Key | 490-1139-1-ND | 4.7nH Unshielded Wirewound Inductor 750mA 70mOhm Max 0402 (1006 Metric) |  |  | 8 | OK
116 | 0.4pF. 50V | 8 | MN57, MN58, MN63, MN64, MN81, MN82, MN87, MN88 | CAP0402 | Murata | GJM1555C1HR40WB01D | Arrow Electronics | GJM1555C1HR40WB01D | 0.4 pF ±0.05pF 50V Ceramic Capacitor C0G, NP0 0402 (1005 Metric) |  |  | 8 | OK
117 | 10nH, 500mA | 4 | MN59, MN61, MN83, MN86 | CAP0402 | Murata | LQW15AN10NG00D | Arrow Electronics | LQW15AN10NG00D | 10 nH Unshielded Wirewound Inductor 500 mA 170mOhm Max 0402 (1005 Metric) |  |  | 4 | OK
118 | 0.3pF, 50V | 8 | MN65, MN66, MN69, MN72, MN97, MN98, MN102, MN104 | CAP0402 | Johanson | QSCF500Q0R3B1GV001T | DigiKey | 712-QSCF500Q0R3B1GV001TCT-ND | 0.3 pF ±0.1pF 50V Ceramic Capacitor C0G, NP0 0402 (1005 Metric) |  |  | 8 | OK
119 | 30nH, 300mA | 4 | MN67, MN70, MN99, MN101 | RES0402 | TDK | MLG1005S30NJT000 | Digi-Key | 445-6312-1-ND | 30 nH Unshielded Multilayer Inductor 300 mA 800mOhm Max 0402 (1005 Metric) |  |  | 4 | OK
120 | 13nH, 400mA | 4 | MN68, MN71, MN100, MN103 | RES0402 | TDK | MLG1005S13NJT000 | Digi-Key | 445-6308-1-ND | 13 nH Unshielded Multilayer Inductor 400 mA 500mOhm Max 0402 (1005 Metric) |  |  | 4 | OK
121 | 10nH, 5% | 2 | MN107, MN109 | RES0402 | COILCRAFT | 0402HP-10NXJLU | Farnell | 2285830 | INDUCTOR, RF, 10NH, 5%, 4.7GHZ, SMD; Product Range:0402HP Series; Inductance:10nH; Inductance Tolerance:± 5%; High Frequency Inductor Case:0402 [1005 Metric]; Self Resonant Frequency Min:4.7GHz; DC Resistance Max:0.11ohm; DC Current Rating:1.3A |  |  | 2 | OK
122 | 10k, 1% | 71 | R1, R2, R3, R4, R5, R11, R12, R23, R28, R30, R32, R34, R49, R56, R60, R61, R62, R63, R64, R71, R72, R122, R137, R176, R202, R203, R204, R205, R206, R236, R247, R287, R297, R299, R301, R315, R325, R327, R329, R343, R353, R355, R357, R371, R381, R383, R385, R390, R391, R392, R393, R394, R402, R443, R444, R454, R455, R468, R482, R504, R506, R511, R512, R513, R514, R515, R524, R529, R530, R531, R540 | RES0402 | Yageo | RC0402FR-0710KL | Digi-Key | 311-10.0KLRTR-ND | RES SMD 10K OHM 1% 1/16W 0402 | NF(R122 R137 R402 R468 R506) | 5 | 66 | OK
123 | 0R | 195 | R6, R16, R19, R20, R21, R22, R26, R29, R31, R33, R35, R47, R59, R65, R70, R75, R76, R80, R81, R82, R83, R84, R87, R88, R92, R93, R94, R95, R96, R99, R100, R104, R105, R106, R107, R108, R113, R114, R115, R116, R117, R118, R121, R128, R129, R130, R131, R132, R133, R136, R144, R145, R146, R155, R156, R157, R168, R169, R170, R171, R172, R173, R174, R175, R182, R183, R194, R195, R196, R197, R198, R199, R218, R219, R223, R224, R225, R232, R235, R240, R241, R242, R243, R245, R246, R248, R249, R250, R251, R252, R253, R254, R261, R262, R263, R264, R271, R272, R275, R276, R298, R300, R302, R303, R304, R326, R328, R330, R331, R332, R354, R356, R358, R359, R360, R382, R384, R386, R387, R388, R389, R395, R403, R404, R405, R406, R407, R408, R409, R410, R411, R412, R420, R425, R426, R427, R429, R430, R431, R433, R434, R435, R436, R438, R440, R442, R446, R447, R448, R461, R466, R470, R471, R472, R473, R475, R477, R478, R479, R480, R481, R483, R484, R485, R486, R487, R488, R489, R490, R491, R492, R493, R494, R495, R496, R497, R498, R500, R501, R502, R503, R505, R507, R508, R509, R510, R553, R555, R557, R574, R575, R580, R581, R584, R586 | RES0402 | Yageo | RC0402JR-070RL | Digi-Key | 311-0.0JRTR-ND | RES SMD 0.0OHM JUMPER 1/16W 0402 | NF(R75 R87 R99 R113 R116 R117 R128 R131 R132 R144 R155 R169 R170 R171 R174 R175 R199 R219 R223 R225 R232 R235 R241 R242 R245 R248 R249 R250 R252 R304 R332 R360 R388 R404 R405 R406 R407 R408 R409 R412 R429 R430 R434 R435 R438 R440 R442 R446 R461 R470 R478 R484 R485 R487 R488 R489 R491 R493 R496 R497 R498 R500 R503 R507 R509 R574 R580 R586) | 68 | 127 | OK
124 | 49.9R, 1% | 49 | R7, R8, R9, R10, R42, R44, R45, R46, R66, R67, R68, R69, R123, R124, R125, R138, R139, R140, R142, R143, R153, R154, R255, R256, R259, R260, R265, R266, R269, R270, R397, R398, R400, R414, R416, R417, R418, R422, R449, R453, R457, R458, R459, R462, R464, R465, R469, R474, R499 | RES0402 | Samsung Electro-Mechanics America, Inc. | RC1005F49R9CS | Digi-Key | 1276-3469-6-ND | RES SMD 49.9 OHM 1% 1/16W 0402 |  |  | 49 | OK
125 | 2k2, 1% | 6 | R13, R14, R57, R58, R73, R74 | RES0402 | Stackpole Electronics Inc | RMCF0402FT2K20 | Digi-Key | RMCF0402FT2K20CT-ND | RES SMD 2.2K OHM 1% 1/16W 0402 |  |  | 6 | OK
126 | 49.9R | 8 | R15, R17, R24, R25, R36, R38, R48, R50 | RES0402 | Samsung Electro-Mechanics America, Inc. | RC1005F49R9CS | Digi-Key | 1276-3469-6-ND | RES SMD 49.9 OHM 1% 1/16W 0402 |  |  | 8 | OK
127 | 100R, 1% | 28 | R18, R27, R39, R52, R120, R135, R163, R166, R207, R212, R217, R220, R221, R222, R226, R229, R257, R258, R267, R268, R278, R306, R334, R362, R399, R413, R415, R463 | RES0402 | Stackpole Electronics Inc. | RMCF0402FT100R | Digi-Key | RMCF0402FT100RDKR-ND | RES SMD 100 OHM 1% 1/16W 0402 | NF(R415) | 1 | 27 | OK
128 | 39R, 1% | 28 | R37, R40, R41, R43, R51, R53, R54, R55, R111, R112, R126, R127, R281, R285, R291, R295, R309, R313, R319, R323, R337, R341, R347, R351, R365, R369, R375, R379 | RES0402 | Yageo | RC0402FR-0739RL | Digi-Key | 311-39.0LRCT-ND | 39 Ohms ±1% 0.063W, 1/16W Chip Resistor 0402 (1005 Metric) Moisture Resistant Thick Film |  |  | 28 | OK
129 | 10R | 12 | R77, R78, R85, R86, R89, R90, R97, R98, R101, R102, R109, R110 | RES0201 | Panasonic Electronic Components | ERJ-1GEF10R0C | Digi-Key | P10.0ABCT-ND | RES SMD 10 OHM 1% 1/20W 0201 |  |  | 12 | OK
130 | 0R | 3 | R79, R91, R103 | RES0201 | Rohm Semiconductor | RC0201FR-070RL | Digi-Key | 311-0.0MCT-ND | RES SMD 0.0OHM JUMPER 1/20W 0201 |  |  | 3 | OK
131 | 4.7k, 1% | 12 | R119, R134, R177, R180, R181, R184, R186, R188, R190, R192, R193, R445 | RES0402 | Yageo | RC0402FR-074K7L | Digi-Key | 311-4.7KLRCT-ND | RES SMD 4.7K OHM 1% 1/16W 0402 | NF(R186 R188) | 2 | 10 | OK
132 | 24R, 1% | 2 | R141, R152 | RES0402 | Yageo | AC0402FR-0724RL | Digi-Key | 13-AC0402FR-0724RLCT-ND | 24 Ohms ±1% 0.063W, 1/16W Chip Resistor 0402 (1005 Metric) Automotive AEC-Q200, Moisture Resistant Thick Film |  |  | 2 | OK
133 | 5.1k, 1% | 2 | R147, R158 | RES0603 | Stackpole Electronics | RMCF0603FT5K10 | Digi-Key | RMCF0603FT5K10CT-ND | 5.1 kOhms ±1% 0.1W, 1/10W Chip Resistor 0603 (1608 Metric) Automotive AEC-Q200 Thick Film |  |  | 2 | OK
134 | 61.9R, 1% | 2 | R148, R159 | RES0402 | Yageo | RC0402FR-0761R9L | Digi-Key | 311-61.9LRCT-ND | 61.9 Ohms ±1% 0.063W, 1/16W Chip Resistor 0402 (1005 Metric) Moisture Resistant Thick Film |  |  | 2 | OK
135 | 22k, 1% | 3 | R149, R160, R547 | RES0402 | Yageo | RC0402FR-0722KL | Digi-Key | 311-22.0KLRCT-ND | RES SMD 22K OHM 1% 1/16W 0402 |  |  | 3 | OK
136 | 249R, 1% | 7 | R150, R151, R161, R162, R178, R179, R239 | RES0402 | Stackpole Electronics Inc | RMCF0402FT249R | Digi-Key | RMCF0402FT249RCT-ND | RES SMD 249 OHM 1% 1/16W 0402 |  |  | 7 | OK
137 | 15R, 1% | 5 | R164, R185, R187, R189, R191 | RES0402 | Yageo | RC0402FR-0715RL | Digi-Key | 311-15LRCT-ND | 15 Ohms ±1% 0.063W, 1/16W Chip Resistor 0402 (1005 Metric) Moisture Resistant Thick Film |  |  | 5 | OK
138 | 1k, 1% | 14 | R165, R167, R401, R451, R467, R565, R566, R567, R571, R572, R573, R576, R577, R582 | RES0402 | Stackpole Electronics Inc | RMCF0402FT1K00 | Digi-Key | RMCF0402FT1K00TR-ND | RES SMD 1K OHM 1% 1/16W 0402 | NF(R401 R467) | 2 | 12 | OK
139 | 200R, 1% | 16 | R200, R201, R208, R209, R210, R211, R214, R215, R227, R228, R230, R231, R233, R234, R237, R238 | RES0402 | Yageo | RC0402FR-07200RL | Digi-Key | 311-200LRCT-ND | 200 ±1% 0.063W, 1/16W Chip Resistor 0402 (1005 Metric) Moisture Resistant Thick Film |  |  | 16 | OK
140 | 3k, 1% | 5 | R213, R216, R396, R460, R551 | RES0402 | Vishay Dale | CRCW04023K00FKED | Digi-Key | 541-3.00KLCT-ND | RES SMD 3K OHM 1% 1/16W 0402 | NF(R396 R460) | 2 | 3 | OK
141 | 10R, 5% | 2 | R244, R450 | RES0402 | Yageo | RC0402JR-0710RL | Digi-Key | 311-10JRTR-ND | RES SMD 10 OHM 5% 1/16W 0402 |  |  | 2 | OK
142 | 2.4k, 1% | 2 | R273, R274 | RES0402 | Yageo | RC0402FR-072K4L | Digi-Key | 311-2.40KLRCT-ND | 2.4 kOhms ±1% 0.063W, 1/16W Chip Resistor 0402 (1005 Metric) Moisture Resistant Thick Film |  |  | 2 | OK
143 | 300R, 1% | 16 | R277, R283, R288, R293, R305, R311, R316, R321, R333, R339, R344, R349, R361, R367, R372, R377 | RES0402 | Vishay Dale | CRCW0402300RFKED | Digi-Key | 541-300LCT-ND | RES SMD 300 OHM 1% 1/16W 0402 |  |  | 16 | OK
144 | 560R, 1% | 19 | R279, R284, R289, R294, R307, R312, R317, R322, R335, R340, R345, R350, R363, R368, R373, R378, R568, R569, R570 | RES0402 | Vishay Dale | CRCW0402560RFKED | Digi-Key | 541-560LCT-ND | RES SMD 560 OHM 1% 1/16W 0402 |  |  | 19 | OK
145 | 120R, 1% | 8 | R280, R290, R308, R318, R336, R346, R364, R374 | RES0402 | Yageo | RC0402FR-07120RL | Digi-Key | 311-120LRCT-ND | 120 Ohms ±1% 0.063W, 1/16W Chip Resistor 0402 (1005 Metric) Moisture Resistant Thick Film |  |  | 8 | OK
146 | 10R, 1% | 16 | R282, R286, R292, R296, R310, R314, R320, R324, R338, R342, R348, R352, R366, R370, R376, R380 | RES0402 |  | RC0402FR-0710RP | Digi-Key | YAG1250CT-ND | 10 Ohms ±1% 0.063W, 1/16W Chip Resistor 0402 (1005 Metric) - Thick Film |  |  | 16 | OK
147 | 0R | 8 | R419, R421, R423, R424, R428, R432, R437, R441 | RES0402_v2 | Yageo | RC0402JR-070RL | Digi-Key | 311-0.0JRTR-ND | RES SMD 0.0OHM JUMPER 1/16W 0402 | NF(R421 R423 R432 R437 R441) | 5 | 3 | OK
148 | 22R, 1% | 1 | R439 | RES0402 | Yageo | RC0402FR-0722RL | Digi-Key | 311-22.0LRTR-ND | RES SMD 22 OHM 1% 1/16W 0402 | NF(R439) | 1 | 0 | OK
149 | 470R, 1% | 2 | R452, R579 | RES0402 |  | RC0402FR-07470RL | Digi-Key | 311-470LRCT-ND | 470 Ohms ±1% 0.063W, 1/16W Chip Resistor 0402 (1005 Metric) Moisture Resistant Thick Film |  |  | 2 | OK
150 | 330R, 5% | 1 | R456 | RES0402 | Yageo | RC0402JR-07330RL | Digi-Key | 311-330JRTR-ND | RES SMD 330 OHM 5% 1/16W 0402 |  |  | 1 | OK
151 | 499R, 1% | 1 | R476 | RES0402 | Vishay | CRCW0402499RFKEDC | Digi-Key | 541-4007-1-ND | 499 Ohms ±1% 0.063W, 1/16W Chip Resistor 0402 (1005 Metric) Thick Film |  |  | 1 | OK
152 | 44.2k, 1% | 10 | R516, R517, R518, R534, R535, R536, R544, R545, R548, R552 | RES0402 | Panasonic Electronic Components | ERJ-2RKF4422X | Digi-Key | P44.2KLCT-ND | RES SMD 44.2K OHM 1% 1/10W 0402 | NF(R516 R517 R518 R534 R535 R536 R548) | 7 | 3 | OK
153 | 124k, 1% | 3 | R519, R520, R521 | RES0402 | Panasonic Electronic Components | ERJ-2RKF1243X | Digi-Key | P124KLCT-ND | RES SMD 124K OHM 1% 1/10W 0402 |  |  | 3 | OK
154 | 15k, 1% | 3 | R522, R523, R541 | RES0402 | Yageo | RC0402FR-0715KL | Digi-Key | 311-15.0KLRCT-ND | 15 kOhms ±1% 0.063W, 1/16W Chip Resistor 0402 (1005 Metric) Moisture Resistant Thick Film, 15 kOhms ±1% 0.063W, 1/16W Chip Resistor 0402 (1005 Metric) Moisture Resistant Thick Film, RES SMD 15K OHM 1% 1/16W 0402 |  |  | 3 | OK
155 | 66.5k | 3 | R525, R526, R527 | RES0402 | Panasonic Electronic Components | ERJ-2RKF6652X | Digi-Key | P66.5KLDKR-ND | RES SMD 66.5K OHM 1% 1/10W 0402 |  |  | 3 | OK
156 | 20k, 1% | 1 | R532 | RES0402 | Vishay | CRCW040220K0FKEDC | Digi-Key | 541-3969-1-ND | 20 kOhms ±1% 0.063W, 1/16W Chip Resistor 0402 (1005 Metric) Thick Film |  |  | 1 | OK
157 | 47.5k, 1% | 1 | R533 | RES0402 | Panasonic Electronic Components | ERJ-2RKF4752X | Digi-Key | P47.5KLCT-ND | RES SMD 47.5K OHM 1% 1/10W 0402 |  |  | 1 | OK
158 | 100k, 1% | 4 | R537, R538, R539, R550 | RES0402 | Vishay Dale | CRCW0402100KFKEDC | Digi-Key | 541-3960-1-ND | 100 kOhms ±1% 0.063W, 1/16W Chip Resistor 0402 (1005 Metric) Thick Film |  |  | 4 | OK
159 | 2.21k, 1% | 1 | R542 | RES0402 | Stackpole Electronics Inc. | RMCF0402FT2K21 | Digi-Key | RMCF0402FT2K21CT-ND | RES SMD 2.21K OHM 1% 1/16W 0402 |  |  | 1 | OK
160 | 47k, 1% | 1 | R543 | RES0402 | Vishay | CRCW040247K0FKEDC | Digi-Key | 541-3966-1-ND | 47 kOhms ±1% 0.063W, 1/16W Chip Resistor 0402 (1005 Metric) Thick Film |  |  | 1 | OK
161 | 80.6k, 1% | 3 | R554, R556, R558 | RES0402 | Stackpole Electronics | RMCF0402FT80K6 | Digi-Key | RMCF0402FT80K6CT-ND | 80.6 kOhms ±1% 0.063W, 1/16W Chip Resistor 0402 (1005 Metric) Automotive AEC-Q200 Thick Film |  |  | 3 | OK
162 | 40.2k, 1% | 3 | R559, R560, R561 | RES0402 | Yageo | RC0402FR-0740K2L | Digi-Key | 311-40.2KLRCT-ND | 40.2 kOhms ±1% 0.063W, 1/16W Chip Resistor 0402 (1005 Metric) Moisture Resistant Thick Film |  |  | 3 | OK
163 | 750R, 1% | 3 | R562, R563, R564 | RES0402 | Yageo | RC0402FR-07750RL | Digi-Key | 311-750LRCT-ND | RES SMD 750 OHM 1% 1/16W 0402 |  |  | 3 | OK
164 | 806R, 1% | 1 | R578 | RES0402 | Stackpole Electronics Inc | RMCF0402FT806R | Digi-Key | RMCF0402FT806RCT-ND | RMCF0402FT806RCT-ND |  |  | 1 | OK
165 | 1.6k, 1% | 1 | R583 | RES0402 | Yageo | RC0402FR-071K6L | Digi-Key | YAG3045CT-ND | 1.6 kOhms ±1% 0.063W, 1/16W Chip Resistor 0402 (1005 Metric) Moisture Resistant Thick Film |  |  | 1 | OK
166 | 510R, 1% | 1 | R585 | RES0402 | Yageo | RC0402FR-07510RL | Digi-Key | 311-510LRCT-ND | 510 Ohms ±1% 0.063W, 1/16W Chip Resistor 0402 (1005 Metric) Moisture Resistant Thick Film |  |  | 1 | OK
167 | 4 bit switch | 1 | SW1 | DS02C-254-1L-04BE_DIP_SWITCH_4PIN | CUI Devices | DS02C-254-1L-04BE | Digi-Key | 2223-DS02C-254-1L-04BE-ND | Dip Switch SPST Position Through Hole, Right Angle Piano Actuator 25mA 24VDC |  |  | 1
168 | TCM1-63AX+ | 12 | T1, T2, T7, T8, T9, T10, T11, T12, T13, T14, T16, T17 | TCM1-63AX+_v2 | Mini-circuits | TCM1-63AX+ | Mini-circuits | TCM1-63AX+ | BALUN WIDE BAND |  |  | 12
169 | TC1-1-13M-45+ | 7 | T3, T4, T5, T6, T15, T18, T19 | TC1-1-13MA+_JA4220-AL_ | Minicircuits | TC1-1-13M-45+ | Minicircuits | TC1-1-13M-45+ | RF balun; 1:1 ratio; 3 dB bandwidth: 0.3 MHz to 3.5 GHz; 3.8mm x 3.8mm |  |  | 7
170 | TESTPOINT_THT_MINI | 6 | TP1, TP2, TP3, TP4, TP5, TP6 | TP-SMD-LOW_PROFILE | Harwin Inc | S1751-46R | Digi-Key | 952-1478-2-ND | Natural PC Test Point 0.128" x 0.065" x 0.079" (3.25mm x 1.65mm x 2.00mm) Brass, Tin Plating Surface Mount Mounting Type |  |  | 6
171 | DMN6140L | 2 | VT1, VT2 | SOT23-3 | Diodes Incorporated | DMN6140L-13 | Digi-Key | DMN6140L-13DICT-ND | N-Channel 60V 1.6A (Ta) 700mW (Ta) Surface Mount SOT-23 |  |  | 2
172 | XTCLH25M000CHJB0P0 | 1 | XO1 | XO_XTCLH25M000CHJB0P0 | Murata | XTCLH25M000CHJB0P0 | Digi-Key | 490-XTCLH25M000CHJB0P0CT-ND | XTAL OSC VCTCXO 25.0000MHZ CMOS |  |  | 1
173 | ASVV-20.000MHZ-N152-T | 1 | XO2 | XO_ASVV-20.000MHZ-N152-T | Abracon | ASVV-20.000MHZ-N152-T | Digi-Key | 535-9344-1-ND | XTAL OSC VCXO 20.0000MHZ CMOS |  |  | 1
174 | U7475LF 30.72MHz | 1 | XO3 | AOCJYR-10.000MHz | Rakon | U7475LF 30.72MHz | Rakon | U7475LF | ROM9070SA 30.72MHz MERC+ 9x7 HOT RC2.5 3.3V PULL |  |  | 1
175 | E6245LF 30.72 MHz | 1 | XO4 | RAKON_RPT7050A | Rakon | E6245LF | Rakon | E6245LF | TCXO 30.72MHz, E6245LF | NF(XO4) | 1 | 0
176 | E5280LF 30.72MHz | 1 | XO5 | RAKON_TXCO | Rakon | E5280LF | Rakon | E5280LF | TCXO 30.72MHz, E5280LF | NF(XO5) | 1 | 0
177 | RTX5032A, 40.00MHz | 1 | XO6 | RAKON_RTX5032A | Rakon | RTX5032A | RAKON | RTX5032A | RTX5032A 40MHz, High performance TCXO, With VC, Filter Enabled, 10-pin 5mm x 3.2 mm x 1.65 mm package | NF(XO6) | 1 | 0
178 | 38.4MHz VCTCXO | 1 | XO7 | CRYSTAL_4-LCC_2P5x2P0 | Abracon | ASVTX-12-A-38.400MHZ-H10-T | Digi-Key | 535-11790-1-ND | 38.4MHz VCTCXO Clipped Sine Wave Oscillator 3V 4-SMD, No Lead | NF(XO7) | 1 | 0
179 | SG3225 | 1 | XO8 | CRYSTAL_6-LCC | Epson | SG3225VAN100.000000M-KEGA3 | Digi-Key | SER4356CT-ND | 100MHz XO (Standard) LVDS Oscillator 2.5V ~ 3.3V Enable/Disable 6-SMD, No Lead |  |  | 1
180 | 25MHz | 1 | XT1 | CRYSTAL_4-LCC | ABRACON | ABM8-25.000MHZ-B2-T | Newark | 13J1767 | 25MHz ±20ppm Crystal 18pF 50 Ohm -20°C ~ 70°C Surface Mount 4-SMD, No Lead (DFN, LCC) |  |  | 1
 |  |  |  |  |  |  |  |  |  |  |  |  | 176
 |  |  |  |  |  |  |  |  |  |  |  | Total NF element number: 176
 |  |  |  |  |  |  |  |  |  |  |  | All NF elements in one row:
 |  |  |  |  |  |  |  |  |  |  |  | NF(BATT1 BATTH1 C748 C758 C771 C772 C502 C725 C747 C759 C767 C768 C947 C279 C302 C520 C521 C522 C523 C267 C290 C319 C346 C309 C336 C902 C852 C855 C858 C882 C760 C798 C799 C800 C801 C804 C805 C885 C903 ESD1 ESD2 ESD3 ESD4 ESD5 ESD6 ESD7 ESD8 ESD9 ESD10 ESD11 ESD12 ESD13 ESD14 FR156 FR157 FR161 FR163 FUSE1 R528 R546 IC40 IC45 IC60 IC63 J32 J20 MECH15 MECH16 MECH17 MECH18 MN35 MN37 MN11 MN13 MN27 MN29 MN43 MN44 MN94 R122 R137 R402 R468 R506 R75 R87 R99 R113 R116 R117 R128 R131 R132 R144 R155 R169 R170 R171 R174 R175 R199 R219 R223 R225 R232 R235 R241 R242 R245 R248 R249 R250 R252 R304 R332 R360 R388 R404 R405 R406 R407 R408 R409 R412 R429 R430 R434 R435 R438 R440 R442 R446 R461 R470 R478 R484 R485 R487 R488 R489 R491 R493 R496 R497 R498 R500 R503 R507 R509 R574 R580 R586 R415 R186 R188 R401 R467 R396 R460 R421 R423 R432 R437 R441 R439 R516 R517 R518 R534 R535 R536 R548 XO4 XO5 XO6 XO7)
 |  |  |  |  |  |  |  |  |  |  |  | *NOTE: NF(R1 R2) means that elements R1 and R2 are unpopulated (NF)
