myriadrf/LimeSDR-X3/(list of files, drawings)

Other design files:
hardware/1v0/LimeSDR-X3_1v0.PrjPcb
hardware/1v0/Schematics/01_BlockDiagram.SchDoc
hardware/1v0/Schematics/02_PowerDiagram.SchDoc
hardware/1v0/Schematics/03_ClockDiagram.SchDoc
hardware/1v0/Schematics/04_RFDiagram.SchDoc
hardware/1v0/Schematics/05_LMS1_Misc.SchDoc
hardware/1v0/Schematics/06_LMS2_Misc.SchDoc
hardware/1v0/Schematics/07_LMS3_Misc.SchDoc
hardware/1v0/Schematics/08_LMS1_RF.SchDoc
hardware/1v0/Schematics/09_LMS2_RF.SchDoc
hardware/1v0/Schematics/10_LMS3_RF.SchDoc
hardware/1v0/Schematics/11_LMS1_Power.SchDoc
hardware/1v0/Schematics/12_LMS2_Power.SchDoc
hardware/1v0/Schematics/13_LMS3_Power.SchDoc
hardware/1v0/Schematics/14_LMS1_RF_PA.SchDoc
hardware/1v0/Schematics/15_LMS2_RF1_Misc.SchDoc
hardware/1v0/Schematics/16_LMS2_RF2_Misc.SchDoc
hardware/1v0/Schematics/17_FPGA_B12_B13_B14_B15.SchDoc
hardware/1v0/Schematics/18_FPGA_B16_B33_B34_B35.SchDoc
hardware/1v0/Schematics/19_FPGA_misc.SchDoc
hardware/1v0/Schematics/20_FPGA_Power.SchDoc
hardware/1v0/Schematics/21_Peripherals.SchDoc
hardware/1v0/Schematics/22_LMS2_TX_BB_DACs.SchDoc
hardware/1v0/Schematics/23_LMS2_RX1_BB_ADC.SchDoc
hardware/1v0/Schematics/24_LMS2_RX2_BB_ADC.SchDoc
hardware/1v0/Schematics/25_LMS3_RX1_BB_ADC.SchDoc
hardware/1v0/Schematics/26_LMS3_RX2_BB_ADC.SchDoc
hardware/1v0/Schematics/27_WR_PTP.SchDoc
hardware/1v0/Schematics/28_Clocks1.SchDoc
hardware/1v0/Schematics/29_Clocks2.SchDoc
hardware/1v0/Schematics/30_Power1.SchDoc
hardware/1v0/Schematics/31_Power2.SchDoc
hardware/1v1/LimeSDR-X3_1v1.PrjPcb
hardware/1v2/LimeSDR-X3_1v2.PrjPcb
hardware/1v2/Schematics/01_BlockDiagram.SchDoc
hardware/1v2/Schematics/02_PowerDiagram.SchDoc
hardware/1v2/Schematics/03_ClockDiagram.SchDoc
hardware/1v2/Schematics/04_RFDiagram.SchDoc
hardware/1v2/Schematics/05_LMS1_Misc.SchDoc
hardware/1v2/Schematics/06_LMS2_Misc.SchDoc
hardware/1v2/Schematics/07_LMS3_Misc.SchDoc
hardware/1v2/Schematics/08_LMS1_RF.SchDoc
hardware/1v2/Schematics/09_LMS2_RF.SchDoc
hardware/1v2/Schematics/10_LMS3_RF.SchDoc
hardware/1v2/Schematics/11_LMS1_Power.SchDoc
hardware/1v2/Schematics/12_LMS2_Power.SchDoc
hardware/1v2/Schematics/13_LMS3_Power.SchDoc
hardware/1v2/Schematics/14_LMS1_RF_PA.SchDoc
hardware/1v2/Schematics/15_LMS2_RF1_Misc.SchDoc
hardware/1v2/Schematics/16_LMS2_RF2_Misc.SchDoc
hardware/1v2/Schematics/17_FPGA_B12_B13_B14_B15.SchDoc
hardware/1v2/Schematics/18_FPGA_B16_B33_B34_B35.SchDoc
hardware/1v2/Schematics/19_FPGA_misc.SchDoc
hardware/1v2/Schematics/20_FPGA_Power.SchDoc
hardware/1v2/Schematics/21_Peripherals.SchDoc
hardware/1v2/Schematics/22_LMS2_TX_BB_DACs.SchDoc
hardware/1v2/Schematics/23_LMS2_RX1_BB_ADC.SchDoc
hardware/1v2/Schematics/24_LMS2_RX2_BB_ADC.SchDoc
hardware/1v2/Schematics/25_LMS3_RX1_BB_ADC.SchDoc
hardware/1v2/Schematics/26_LMS3_RX2_BB_ADC.SchDoc
hardware/1v2/Schematics/27_WR_PTP.SchDoc
hardware/1v2/Schematics/28_Clocks1.SchDoc
hardware/1v2/Schematics/29_Clocks2.SchDoc
hardware/1v2/Schematics/30_Power1.SchDoc
hardware/1v2/Schematics/31_Power2.SchDoc
