myriadrf/LimeSDR-X3/(commit log)

2023-01-11 Altium project of v1.0 added.
    [01_BlockDiagram.SchDoc, 02_PowerDiagram.SchDoc, 03_ClockDiagram.SchDoc, 04_RFDiagram.SchDoc, 05_LMS1_Misc.SchDoc, 06_LMS2_Misc.SchDoc, 07_LMS3_Misc.SchDoc, 08_LMS1_RF.SchDoc]
2023-06-20 Initial commit for 1v1
    [01_BlockDiagram.SchDoc, 02_PowerDiagram.SchDoc, 03_ClockDiagram.SchDoc, 04_RFDiagram.SchDoc, 05_LMS1_Misc.SchDoc, 06_LMS2_Misc.SchDoc, 07_LMS3_Misc.SchDoc, 08_LMS1_RF.SchDoc]
2023-06-20 Update LimeSDR-X3_1v1.PrjPcb
    Added library to project
    [LimeSDR-X3_1v1.PrjPcb]
2023-06-20 Removed old compiled library
    [LimeSDR-X3_1v1.PrjPcb]
2023-06-20 schematic and PCB version nr changed to 1v1
    [01_BlockDiagram.SchDoc, 02_PowerDiagram.SchDoc, 03_ClockDiagram.SchDoc, 04_RFDiagram.SchDoc, 05_LMS1_Misc.SchDoc, 06_LMS2_Misc.SchDoc, 07_LMS3_Misc.SchDoc, 08_LMS1_RF.SchDoc]
2023-06-20 Marked todo changes
    [31_Power2.SchDoc]
2023-06-20 Deleted LMS1 TX1 PA
    [14_LMS1_RF_PA.SchDoc]
2023-06-20 Connected QPA4563A + F2258NLGK8 + QPA4563A for both LMS1_TX channels
    [14_LMS1_RF_PA.SchDoc]
2023-06-20 Added PA input notes
    [14_LMS1_RF_PA.SchDoc]
2023-06-20 Changed LMS_TX1 and LMS_TX2 switches output capacitors
    [08_LMS1_RF.SchDoc]
2023-06-21 Added common power filter for LMS1_TX1 and LMS1_TX2 circuits
    [14_LMS1_RF_PA.SchDoc]
2023-06-21 Added 2.5Vref option for VVA DACs
    [14_LMS1_RF_PA.SchDoc]
2023-06-21 Changed VREF type
    [31_Power2.SchDoc]
2023-06-21 Changed diagrams sheets size to A3
    [01_BlockDiagram.SchDoc, 02_PowerDiagram.SchDoc, 03_ClockDiagram.SchDoc, 04_RFDiagram.SchDoc, LimeSDR-X3_1v1.PrjPcb]
2023-06-21 Updated diagrams
    [01_BlockDiagram.SchDoc, 02_PowerDiagram.SchDoc, 03_ClockDiagram.SchDoc, 04_RFDiagram.SchDoc]
2023-06-21 LMZ10501 regulators changed to LMZ20501SILR
    [31_Power2.SchDoc]
2023-06-21 Reannotated and pushed to PCB
    [01_BlockDiagram.SchDoc, 02_PowerDiagram.SchDoc, 03_ClockDiagram.SchDoc, 04_RFDiagram.SchDoc, 05_LMS1_Misc.SchDoc, 06_LMS2_Misc.SchDoc, 07_LMS3_Misc.SchDoc, 08_LMS1_RF.SchDoc]
2023-06-21 Added LMS1 Core_LDO manual config option
    [05_LMS1_Misc.SchDoc]
2023-06-21 schematic reannotated and pushed to PCB
    [01_BlockDiagram.SchDoc, 02_PowerDiagram.SchDoc, 03_ClockDiagram.SchDoc, 04_RFDiagram.SchDoc, 05_LMS1_Misc.SchDoc, 06_LMS2_Misc.SchDoc, 07_LMS3_Misc.SchDoc, 08_LMS1_RF.SchDoc]
2023-06-22 Increased HW_VER value
    [17_FPGA_B12_B13_B14_B15.SchDoc, 19_FPGA_misc.SchDoc]
2023-06-22 Changed schematic prints file name to r0
2023-06-22 Cosmetic changes
    [28_Clocks1.SchDoc]
2023-06-22 Updated block diagram
    [01_BlockDiagram.SchDoc]
2023-06-22 Updated power diagram
    [02_PowerDiagram.SchDoc]
2023-06-22 Updated clock diagram
    [03_ClockDiagram.SchDoc]
2023-06-22 Updated RF diagram
    [04_RFDiagram.SchDoc]
2023-06-22 Added draftsman file
    [LimeSDR-X3_1v1.PrjPcb]
2023-06-22 PCB synchronized
    [LimeSDR-X3_1v1.PrjPcb]
2023-06-23 NF lists updated, BOM generated and checked, BOM errors fixed
    [08_LMS1_RF.SchDoc, 11_LMS1_Power.SchDoc, 12_LMS2_Power.SchDoc, 13_LMS3_Power.SchDoc, 14_LMS1_RF_PA.SchDoc, 15_LMS2_RF1_Misc.SchDoc, 16_LMS2_RF2_Misc.SchDoc, 19_FPGA_misc.SchDoc]
2023-06-28 Removed marked changes
    [05_LMS1_Misc.SchDoc]
2024-06-11 Fan spacers added, DFMr1 created
    - Added 3 pcs. of spacers MECH20, MECH21, MECH22 to MECH2, MECH3, MECH4, MECH5 (TDYSFF-M3/10) for second fan;
    - Added 8 pcs. of screws MECH23, MECH24, MECH25, MECH26, MECH27, MECH28 to MECH6, MECH7, MECH8, MECH9, MECH10, MECH11, MECH12, MECH13 (1003755) for second fan;
    - Added 1 pcs. of header receptacle MECH29 to MECH14 (0014562021) for second fan;
    - BOM updated;
    - New schematic generated;
    - Other PDF document names changed from r0 to r1;
    - All other DFM files left unchanged.
    [05_LMS1_Misc.SchDoc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]
2024-06-12 Change list mistake corrected
    dded --->6<--- pcs. of screws MECH23, MECH24, MECH25, MECH26, MECH27, MECH28
2024-09-23 Initial LimeSDR-X3_1v2 version
    [01_BlockDiagram.SchDoc, 02_PowerDiagram.SchDoc, 03_ClockDiagram.SchDoc, 04_RFDiagram.SchDoc, 05_LMS1_Misc.SchDoc, 06_LMS2_Misc.SchDoc, 07_LMS3_Misc.SchDoc, 08_LMS1_RF.SchDoc]
2024-09-24 RF UFL changed to MCX connectors, LED silkscreen fixed
    [08_LMS1_RF.SchDoc, 10_LMS3_RF.SchDoc, 14_LMS1_RF_PA.SchDoc, 15_LMS2_RF1_Misc.SchDoc, 16_LMS2_RF2_Misc.SchDoc]
2024-09-24 HW version updated
    [17_FPGA_B12_B13_B14_B15.SchDoc, 19_FPGA_misc.SchDoc]
2025-01-09 PMOD connector schematic updated
    [21_Peripherals.SchDoc]
2025-01-09 PCB updated
    [21_Peripherals.SchDoc, LimeSDR-X3_1v2.PrjPcb]
2025-01-10 RF cut-outs added, OCXO thermal case holes increased to 1.5mm
2025-01-10 PMOD and XO1 change notes updated
    [21_Peripherals.SchDoc, 28_Clocks1.SchDoc]
